YannyOh/BlasterProof-II/docs/img/shell_usb_end.png

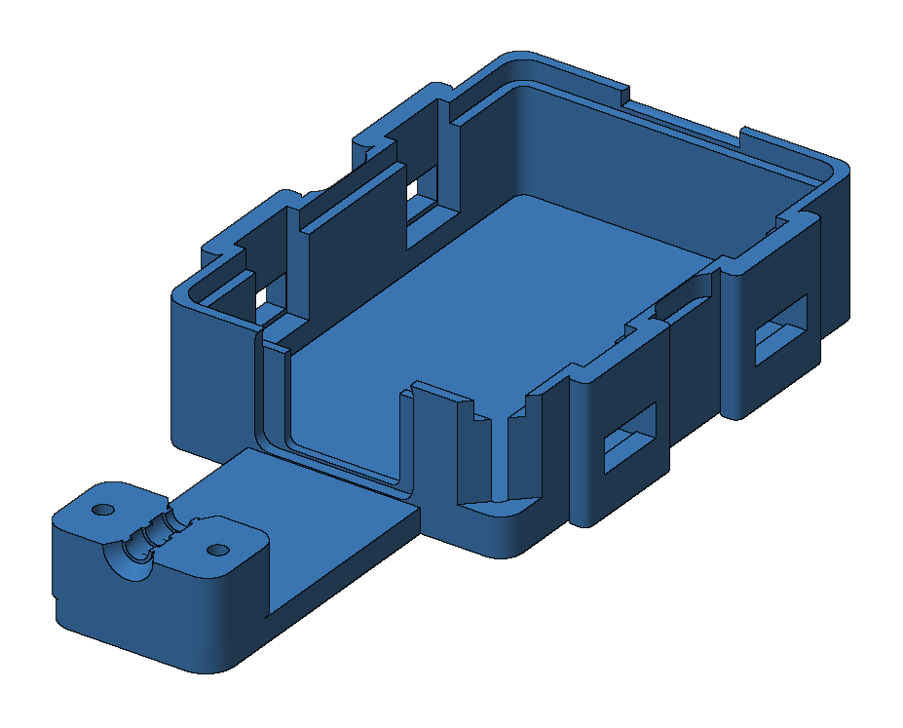
docs/img/shell_usb_end.png
