YannyOh/BlasterProof-II/cad/step/shell_insert.step

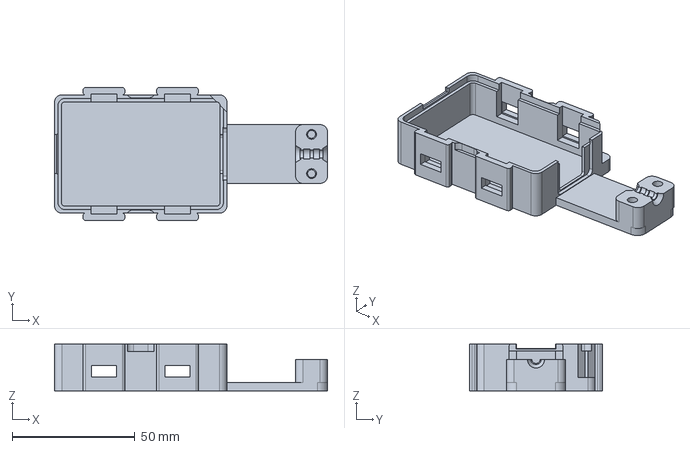
[picture p13: CAD file, 2026-10-17]
cad/step/shell_insert.step
111.3 x 54.2 x 19.0 mm
