YannyOh/BlasterProof-II/cad/step/cover.step

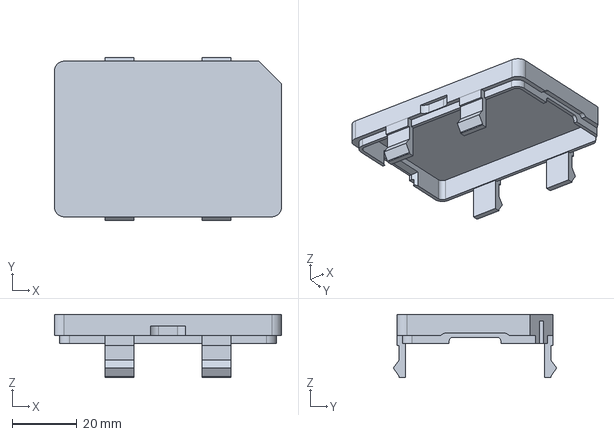
[picture p14: CAD file, 2026-10-17]
cad/step/cover.step
70.3 x 50.6 x 19.6 mm
