YannyOh/BlasterProof-II/cad/step/clamp_cap.step

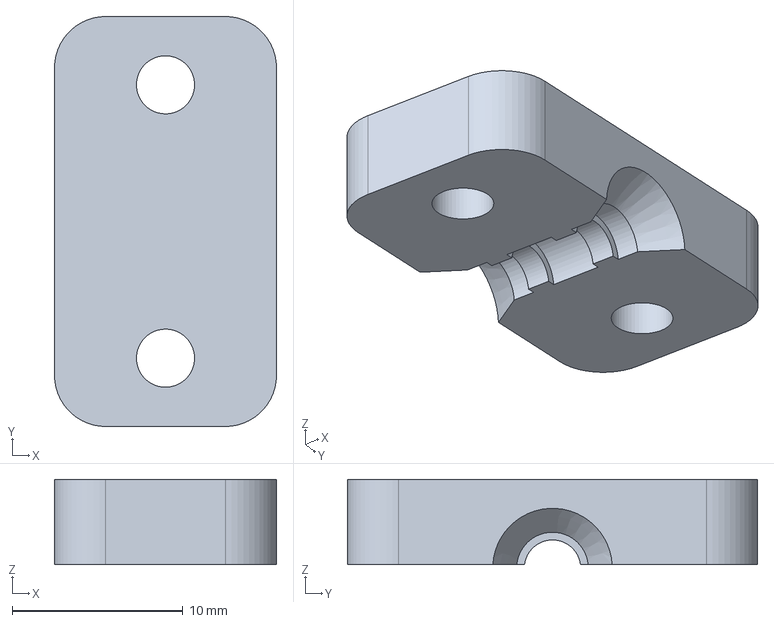
[picture p15: CAD file, 2026-10-17]
cad/step/clamp_cap.step
13.0 x 24.0 x 5.00 mm
