YannyOh/BlasterProof-II/cad/step/shell_selftap.step

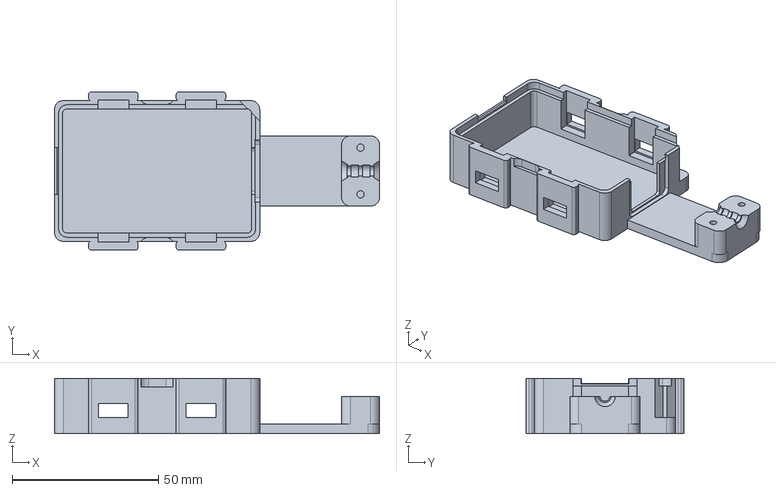
[picture p16: CAD file, 2026-10-17]
cad/step/shell_selftap.step
111.3 x 54.2 x 19.0 mm
