YannyOh/BlasterProof-II/(list of files, cad)

Other CAD files:
print/clamp_cap.3mf
print/clamp_cap.stl
print/cover.3mf
print/cover.stl
print/shell_insert.3mf
print/shell_insert.stl
print/shell_selftap.3mf
print/shell_selftap.stl
