YannyOh/BlasterProof-II/(commit log)

2026-10-17 BLASTERPROOF II v2.1 - design as handed over
    Source cradle_cq.py (v2.1) plus the final export set from out/.
    Note: the exports in this commit are newer than the source (longer
    tail, cable groove along the cable); v2.2 reconciles the two.
    Claude-Session: https://claude.ai/code/session_01BEu7mhFesvej8pLiHSaB1a
    [clamp_cap.3mf, clamp_cap.step, clamp_cap.stl, cover.3mf, cover.step, cover.stl, screws_x2.3mf, screws_x2.step]
2026-10-17 BLASTERPROOF II v2.2 - metal M3 hardware, reconciled source, PPD + 1:1 drawing
    - cradle_cq.py now reproduces the final exports (cable groove along the
    cable, axis at pod mid-height 12.8 mm, 41 mm tail, bell-mouth ends)
    - printed screws dropped; shell exported as shell_selftap (M3 self-tap)
    and shell_insert (M3 heat-set insert + thumb screw)
    - Production Procedure Document (md + pdf), two-sheet A4 drawing with
    sheet 1 at 1:1, renders, verification report, doc-build tools
    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
    [clamp_cap.3mf, clamp_cap.step, clamp_cap.stl, cover.3mf, cover.step, screws_x2.3mf, screws_x2.step, screws_x2.stl]
2026-10-26 README: note v2.1 field-tested, v2.2 CAD-verified
